acastles91/OpenCelluloid2/export.png

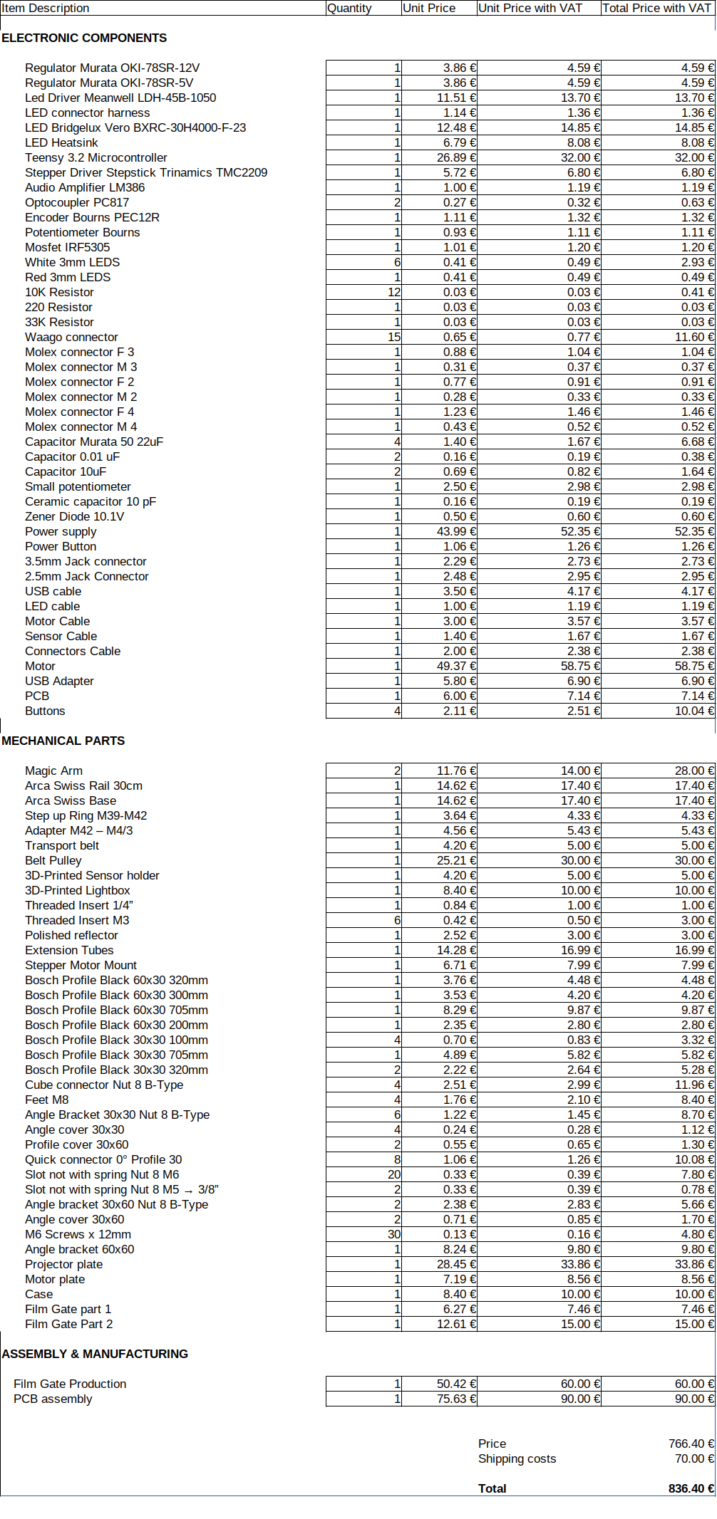
export.png
