acastles91/OpenCelluloid2/OC_Material+Einkaufs_Liste.ods

Name | Quantity | Unit Price | Total Price | Links
Regulator Murata OKI-78SR-12V | 1
Regulator Murata OKI-78SR-5V | 1
Led Driver Meanwell LDH-45B-1050 | 1
LED Bridgelux Vero | 1
Heatsink
Teensy 3.2
Stepper Driver Trinamics TMC2209
Audio Amplifier LM386
Optocoupler PC817 | 2
Encoder Bourns PEC12R
Potentiometer Bourns
Mosfet IRF5305 | 1
White 3mm LEDS | 6
Red 3mm LEDS | 1
10K Resistor | 7
30K Resistor | 1
Waago connector | 15
Molex connector 3 | 1
Molex connector 2 | 1
Molex connector 4 | 1
Magic Arm | 2 | 14,00 € | 28,00 € | https://www.ebay.de/itm/SmallRig-1498-Schwenkarm-Gelenkarm-Magic-Arm-1-4-Gewinde-drehbar-max-275mm-lang/163190397732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
Arca Swiss Schiene30cm | 1 | 17,40 € | 17,40 € | https://www.ebay.de/itm/MENGS-BPL-300-Mehrzweck-Schiene-Aluminium-Legierung-F%C3%BCr-DSLR-Kamera-Arca-Swiss/183012073690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
Arca Swiss Aufnahmeplatte | 1 | 17,40 € | 17,40 € | https://www.ebay.de/itm/MENGS-CL-90N-Schnellkupplungen-F%C3%BCr-Arca-Swiss-Platte-und-Stativ-mit-Arca-Swiss/323217049120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
Objektivadapter M42 | 1 | 4,33 € | 4,33 € | https://www.ebay.de/itm/Hohe-Pr%C3%A4zision-Metall-M39-M42-Schraube-Objektiv-Objektivadapter-Step-Up-Ri-BF/123957863239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 (https://www.ebay.de/itm/Hohe-Präzision-Metall-M39-M42-Schraube-Objektiv-Objektivadapter-Step-Up-Ri-BF/123957863239?ssPageName=STRK%3AMEBIDX%3AIT)
Objektivadapter M42 – M4/3 | 1 | 5,43 € | 5,43 € | https://www.ebay.de/itm/M42-M4-3-Adapter-f%C3%BCr-M42-Objektiv-zum-Schrauben-an-Micro-4-3-fu/283733808588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
Riemenpauschale | 1 | 5,00 € | 5,00 € | Flachrieben/ Rundriemen/ Rippenriemen
Riemenscheibe | 1 | 30,00 € | 30,00 € | eigene Fertigung
Sensor | 1 | ? | 0,00 € | ?
3D-Druck Sensorhalterung | 1 | 10,00 € | 10,00 € | eigene Fertigung
3D-Druck Lampenkammer | 1 | 20,00 € | 20,00 € | eigene Fertigung
GewindeEinsätze M3 | 5 | 5,00 € | 5,00 € | ?
Spiegelblech | 1 | 3,00 € | 3,00 € | eigene Fertigung
Extension Tubes | 1 | ? | 0,00 € | ?
Objektiv | 1 | ? | 0,00 € | ?
Schrittmotor | 1 | ? | 0,00 € | ?
Schrittmotor Aufhängung | 1 | ? | 0,00 € | ?
Boschprofil Schwarz 60x30 320mm | 1 | 4,48 € | 4,48 € | https://www.myaluprofil.de/aluminiumprofil-30x60-nut-8-b-typ-schwarz.html
Boschprofil Schwarz 60x30 300mm | 1 | 4,20 € | 4,20 € | https://www.myaluprofil.de/aluminiumprofil-30x60-nut-8-b-typ-schwarz.html
Boschprofil Schwarz 60x30 705mm | 1 | 9,87 € | 9,87 € | https://www.myaluprofil.de/aluminiumprofil-30x60-nut-8-b-typ-schwarz.html
Boschprofil Schwarz 60x30 200mm | 1 | 2,80 € | 2,80 € | https://www.myaluprofil.de/aluminiumprofil-30x60-nut-8-b-typ-schwarz.html
Boschprofil Schwarz 30x30 100mm | 4 | 0,83 € | 3,30 € | https://www.myaluprofil.de/aluminiumprofil-30x30-nut-8-b-typ-schwarz.html
Boschprofil Schwarz 30x30 705mm | 1 | 5,82 € | 5,82 € | https://www.myaluprofil.de/aluminiumprofil-30x30-nut-8-b-typ-schwarz.html
Boschprofil Schwarz 30x30 320mm | 2 | 2,64 € | 5,28 € | https://www.myaluprofil.de/aluminiumprofil-30x30-nut-8-b-typ-schwarz.html
Würfelverbindersatz Nut 8 B-Typ | 4 | 2,99 € | 11,96 € | https://www.myaluprofil.de/Wuerfelverbindersatz-30x30-Nut-8-3D-B-Typ.html
Stellfuß M8 | 4 | 2,10 € | 8,40 € | https://www.myaluprofil.de/Stellfuss-D40-M8x60-B-Typ.html
Winkelsatz 30x30 Nut 8 B-Typ | 6 | 1,45 € | 8,70 € | https://www.myaluprofil.de/Winkelsatz-30x30-ZN-Nut-8-B-Typ.html
Winkelabdeckkappe 30x30 | 4 | 0,28 € | 1,12 € | https://www.myaluprofil.de/Winkelabdeckkappe-30x30-ZN-Nut-8-B-Typ.html
Profilabdeckkappe 30x60 | 2 | 0,65 € | 1,30 € | https://www.myaluprofil.de/Profilabdeckkappe-30x60-Nut-8-B-Typ.html
Schnellspannverbinder 0° Profil 30 | 8 | 1,26 € | 10,08 € | https://www.myaluprofil.de/Schnellspannverbinder-0---Profil-30-Nut-8-B-Typ.html
Nutenstein mit Feder Nut 8 M6 | 20 | 0,39 € | 7,08 € | https://www.myaluprofil.de/Nutenstein-mit-Feder-Nut-8-M6-B-Typ.html
Nutenstein mit Feder Nut 8 M5 → 3/8” | 2 | 0,39 € | 0,78 € | https://www.myaluprofil.de/Nutenstein-mit-Feder-Nut-8-M5-B-Typ.html
Winkelsatz 30x60 Nut 8 B-Typ | 2 | 2,83 € | 5,66 € | https://www.myaluprofil.de/Winkelsatz-30x60-ZN-Nut-8-B-Typ.html
Winkelabdeckkappe 30x60 | 2 | 0,85 € | 1,70 € | https://www.myaluprofil.de/Winkelabdeckkappe-30x60-ZN-Nut-8-B-Typ.html
M6 Schrauben x 12mm | 30 | 0,16 € | 5,40 € | https://www.myaluprofil.de/halbrundschraube-iso-7380.html
Winkelsatz 60x60 | 1 | 9,80 € | 9,80 € | https://www.ebay.de/itm/Winkel-60x60-Nut-8-B-Typ-mit-Befestigungssatz-und-Abdeckkappe/274236580490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
Projektorplatte | 1 | 33,86 € | 33,86 € | GeersCutting
Motorplatte | 1 | 8,56 € | 8,56 € | GeersCutting
Caseplatte 1 | 1 | 10,00 € | 10,00 € | GeersCutting
Caseplatte 2 | 1 | 10,00 € | 10,00 € | GeersCutting
Filmgate Teil 1 | 1 | 7,46 € | 7,46 € | GeersCutting
Filmgate Teil 2 | 1 | 15,00 € | 15,00 € | GeersCutting
Filmgate Fertigungspauschale | 1 | 60,00 € | 60,00 € | eigene Fertigung
Lasern Transport Pauschale | 1 | 10,00 € | 10,00 €
 |  | Total: | 408,17 €
