acastles91/OpenCelluloid2/OpenCelluloid.kicad_pcb

## KiCad design OpenCelluloid.kicad_pcb (2021-06-12)

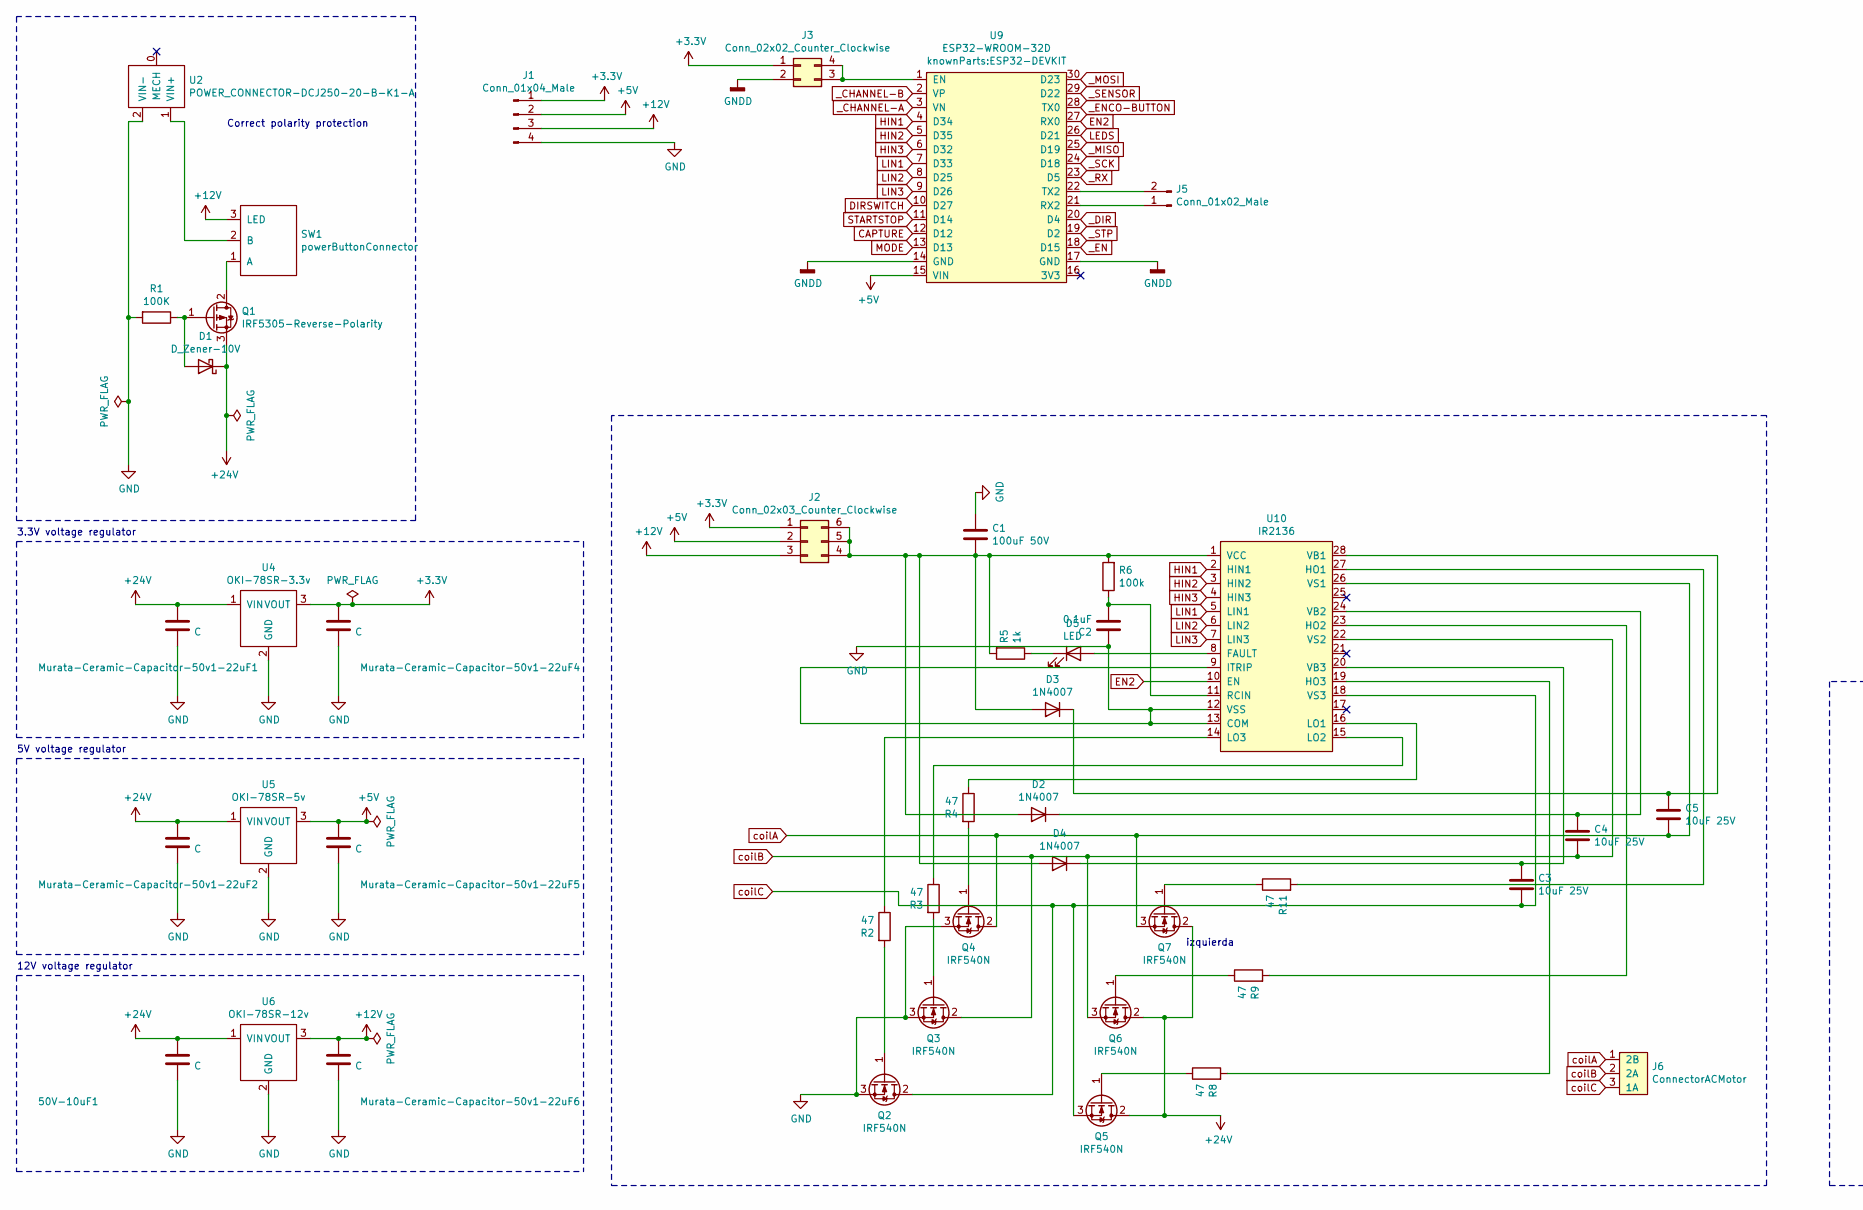
[picture p2: schematic OpenCelluloid.sch, part in row 1, column 1]

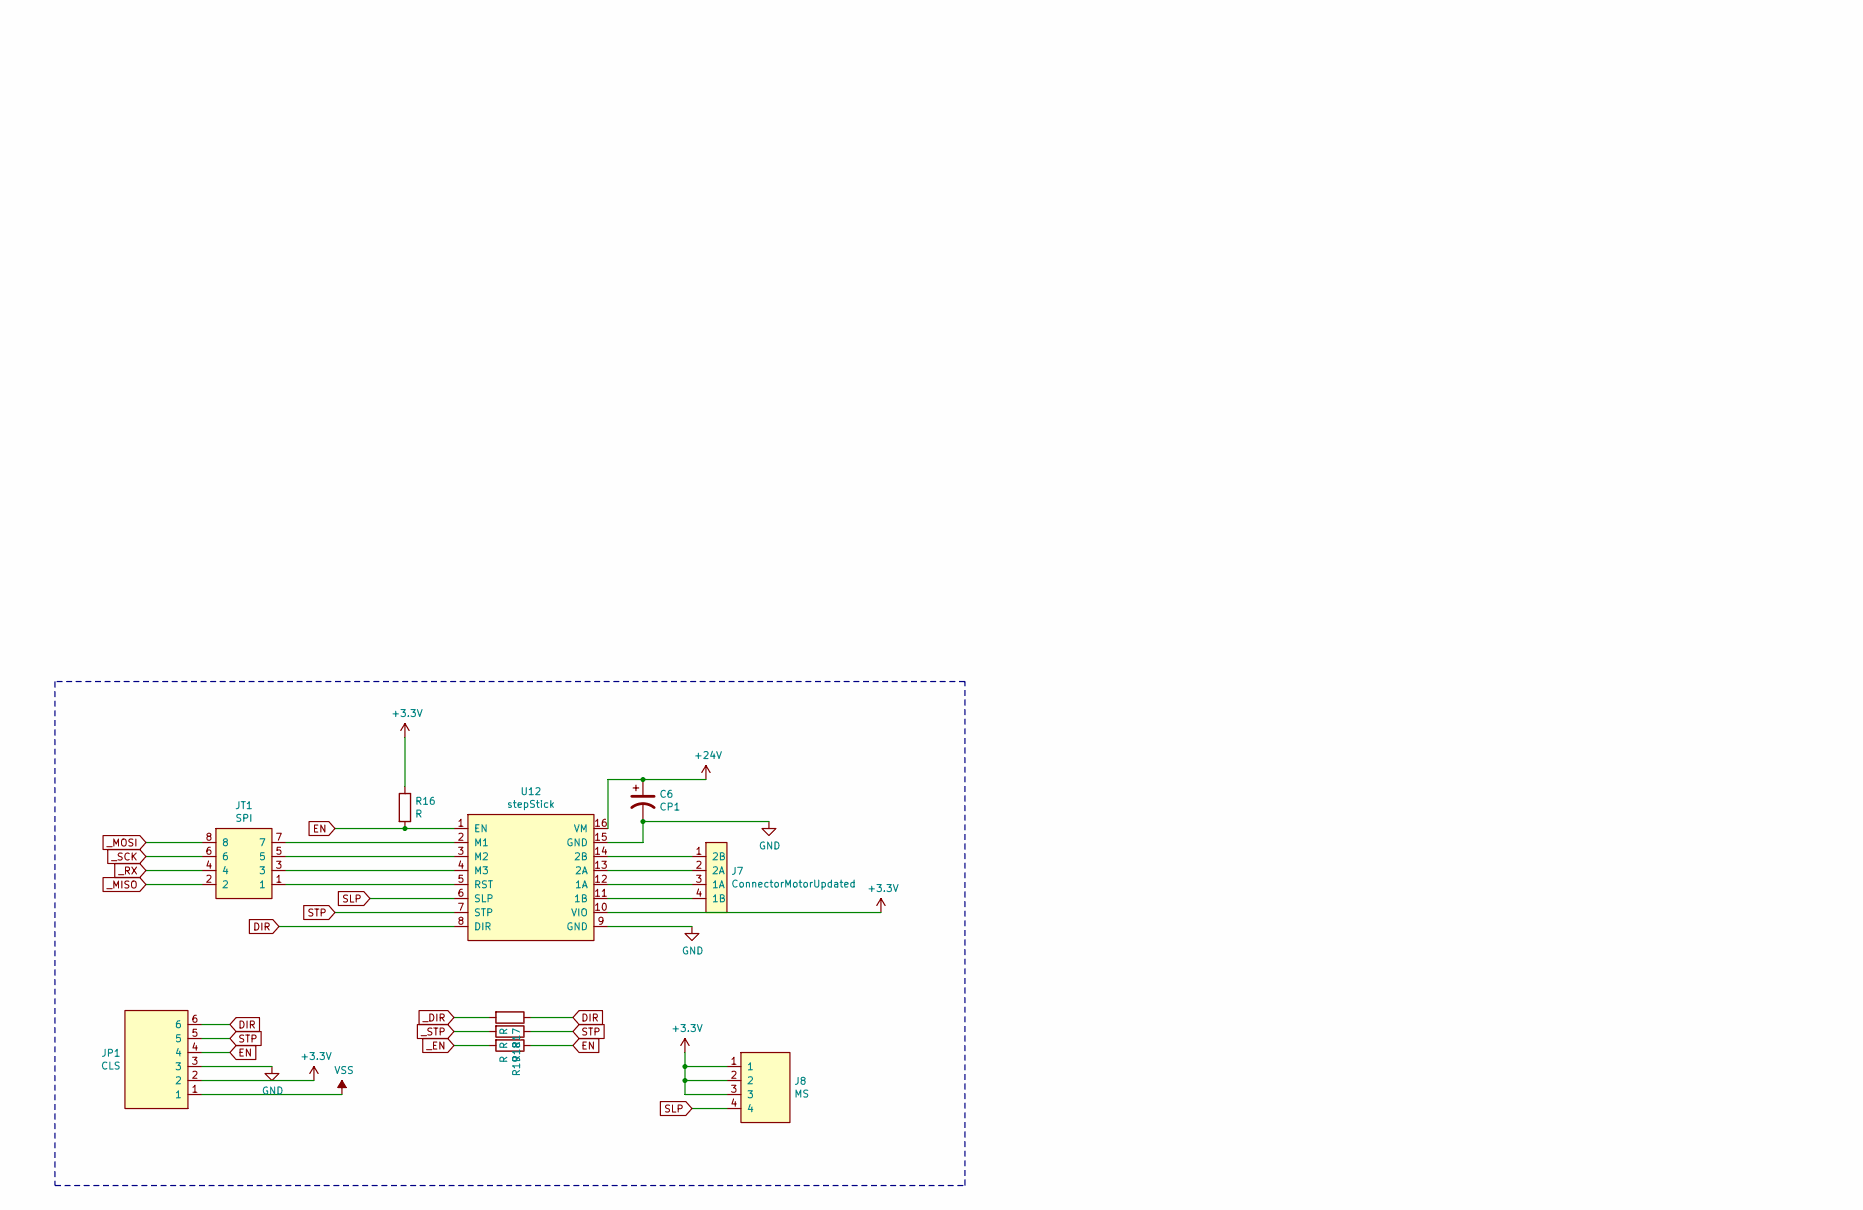
[picture p3: schematic OpenCelluloid.sch, part in row 1, column 2]

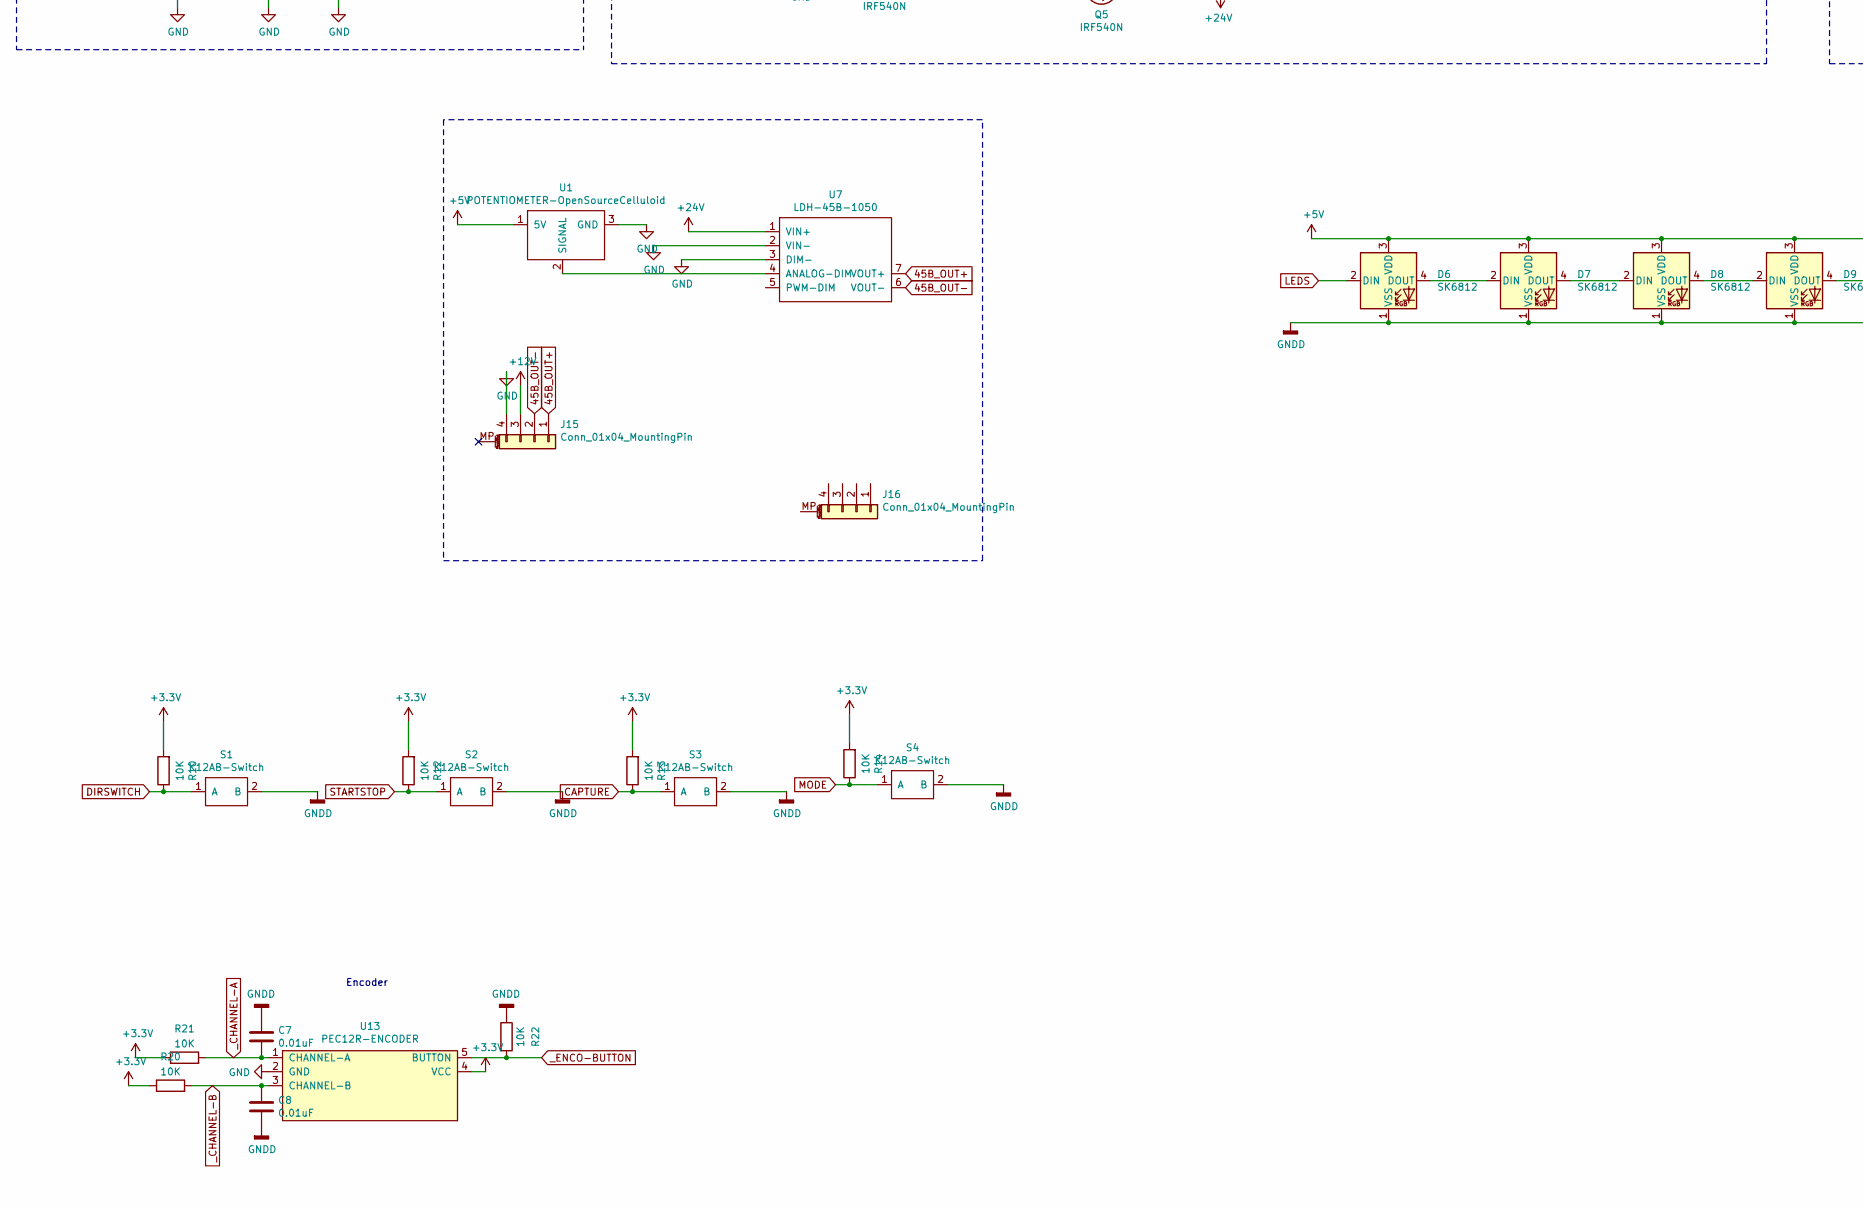
[picture p4: schematic OpenCelluloid.sch, part in row 2, column 1]

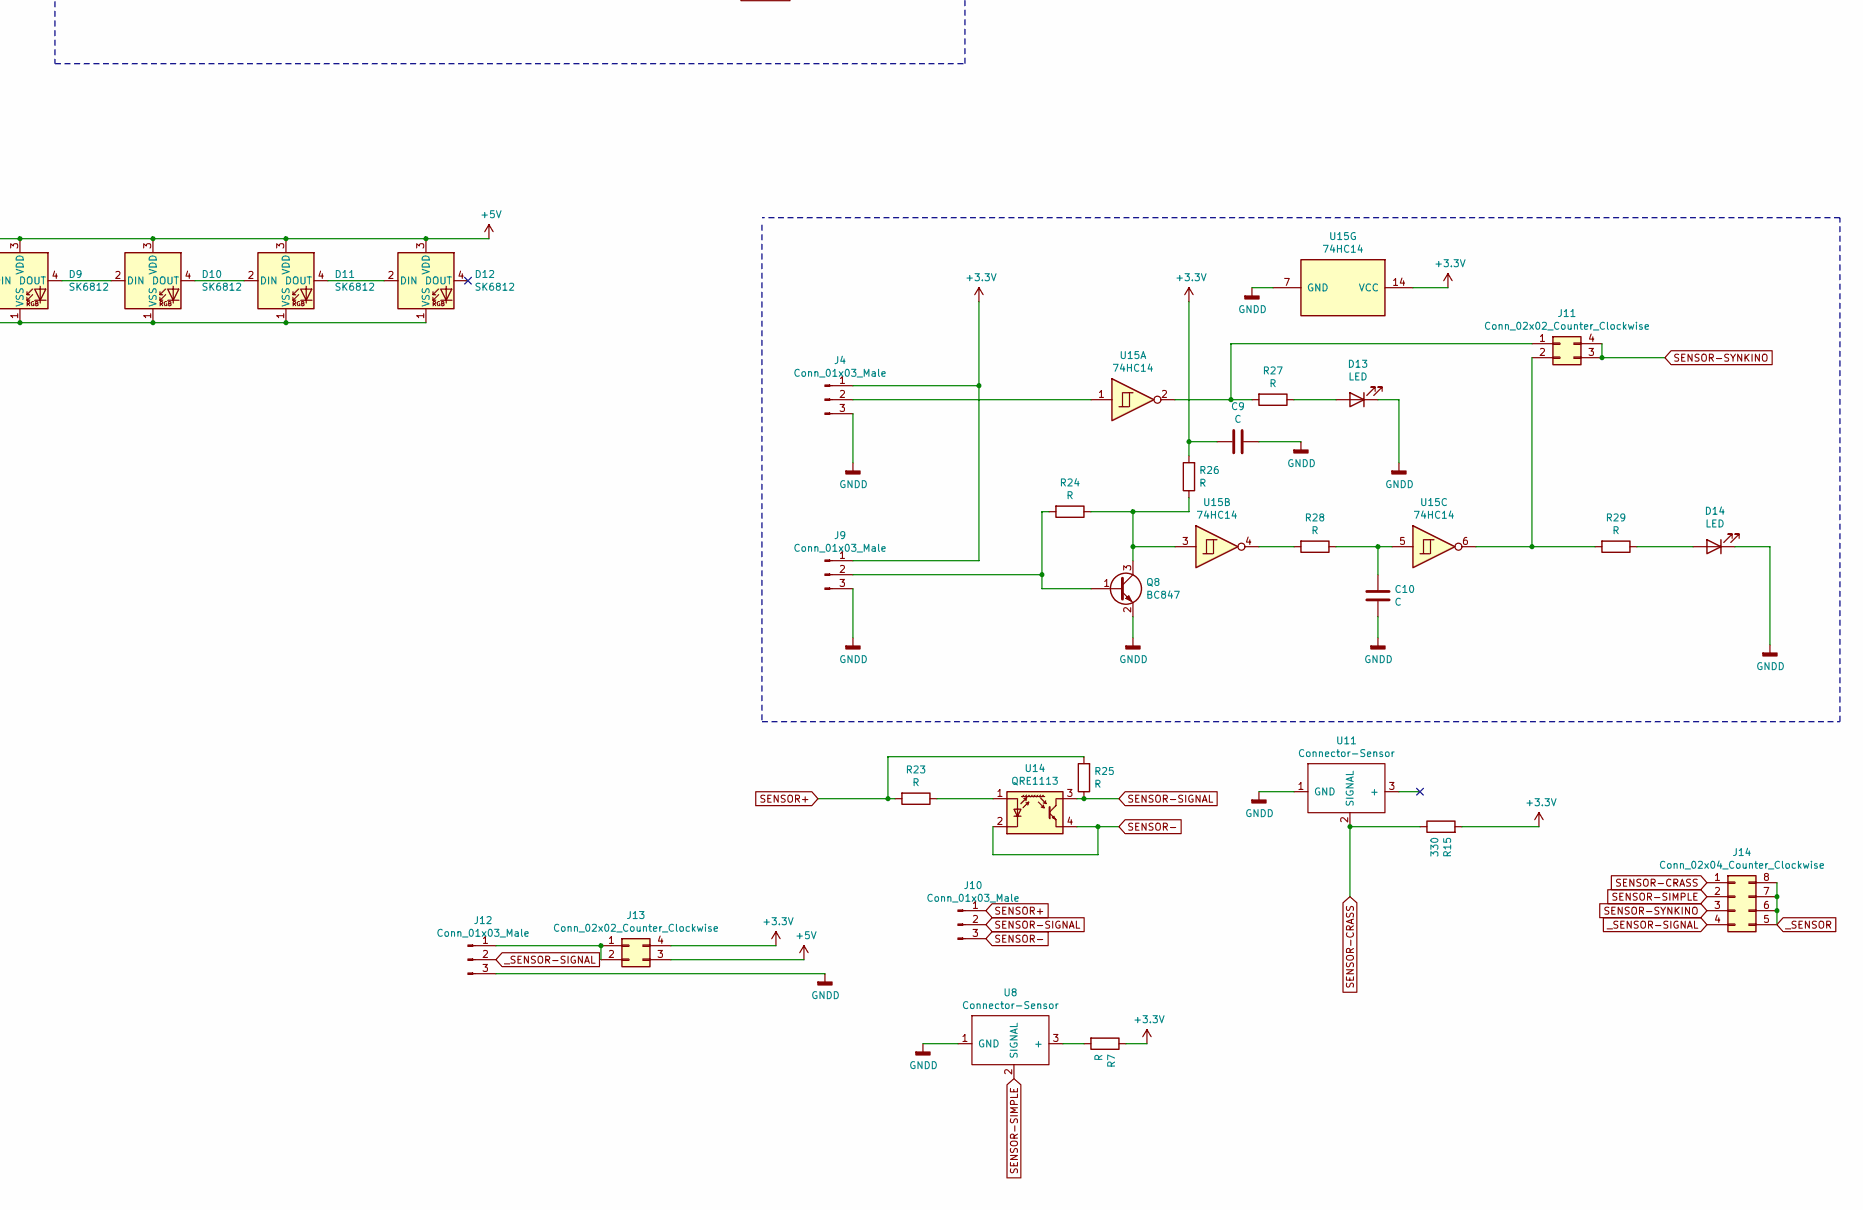
[picture p5: schematic OpenCelluloid.sch, part in row 2, column 2]

Parts:
50V-10uF1: C; C_Disc_D3.0mm_W1.6mm_P2.50mm
C1: 100uF 50V; CP_Radial_D8.0mm_P2.50mm
C2: 0.1uF; C_Disc_D3.0mm_W1.6mm_P2.50mm
C3, C4, C5: 10uF 25V; CP_Radial_D5.0mm_P2.50mm
C6: CP1; CP_Radial_D5.0mm_P2.50mm
C7, C8: 0.01uF; C_Rect_L7.0mm_W3.5mm_P5.00mm
C9, C10: C; C_Rect_L7.0mm_W3.5mm_P5.00mm
D1: D_Zener-10V; D_DO-41_SOD81_P7.62mm_Horizontal
D2, D3, D4: 1N4007; D_DO-41_SOD81_P10.16mm_Horizontal
D5, D13, D14: LED; LED_D3.0mm
D6, D7, D8, D9, D10, D11, D12: SK6812; LED_SK6812_PLCC4_5.0x5.0mm_P3.2mm
J1: Conn_01x04_Male; PinHeader_1x04_P2.54mm_Vertical
J2: Conn_02x03_Counter_Clockwise; PinHeader_2x03_P2.54mm_Vertical-CounterClockWise
J3, J11, J13: Conn_02x02_Counter_Clockwise; PinSocket_2x02_P2.54mm_Vertical_CounterClockWise
J4, J9, J10, J12: Conn_01x03_Male; JST_XH_B3B-XH-A_1x03_P2.50mm_Vertical
J5: Conn_01x02_Male; PinHeader_1x02_P2.54mm_Vertical
J6: ConnectorACMotor; Molex_Micro-Fit_3.0_43650-0300_1x03_P3.00mm_Horizontal
J7: ConnectorMotorUpdated; Molex_Micro-Fit_3.0_43650-0400_1x04_P3.00mm_Horizontal
J8: MS; PinHeader_1x04_P2.54mm_Vertical
J14: Conn_02x04_Counter_Clockwise; PinHeader_2x04_P2.54mm_Vertical-CounterClowckWise
J15: Conn_01x04_MountingPin; Molex_Micro-Fit_3.0_43650-0400_1x04_P3.00mm_Horizontal
J16: Conn_01x04_MountingPin; Vero29_w_Fan
JP1: CLS; PinHeader_1x06_P2.54mm_Vertical
JT1: SPI; PinHeader_2x04_P2.54mm_Vertical
Murata-Ceramic-Capacitor-50v1-22uF1, Murata-Ceramic-Capacitor-50v1-22uF2, Murata-Ceramic-Capacitor-50v1-22uF4, Murata-Ceramic-Capacitor-50v1-22uF5, Murata-Ceramic-Capacitor-50v1-22uF6: C; C_Disc_D3.0mm_W1.6mm_P2.50mm
Q1: IRF5305-Reverse-Polarity; TO-220-3_Horizontal_TabDown
Q2, Q3, Q4, Q5, Q6, Q7: IRF540N; TO-220-3_Horizontal_TabDown
Q8: BC847; SOT-23
R1: 100K; R_Axial_DIN0204_L3.6mm_D1.6mm_P7.62mm_Horizontal
R2, R3, R4, R8, R9, R11: 47; R_Axial_DIN0204_L3.6mm_D1.6mm_P7.62mm_Horizontal
R5: 1k; R_Axial_DIN0204_L3.6mm_D1.6mm_P7.62mm_Horizontal
R6: 100k; R_Axial_DIN0204_L3.6mm_D1.6mm_P7.62mm_Horizontal
R7, R16, R17, R18, R19, R23, R24, R25, R26, R27, R28, R29: R; R_Axial_DIN0204_L3.6mm_D1.6mm_P7.62mm_Horizontal
R10, R12, R13, R14, R20, R21, R22: 10K; R_Axial_DIN0204_L3.6mm_D1.6mm_P7.62mm_Horizontal
R15: 330; R_Axial_DIN0204_L3.6mm_D1.6mm_P7.62mm_Horizontal
S1, S2, S3, S4: K12AB-Switch
SW1: powerButtonConnector; Molex_Micro-Fit_3.0_43650-0300_1x03_P3.00mm_Horizontal
U1: POTENTIOMETER-OpenSourceCelluloid; PDB12-H4301-Potentiometer
U2: POWER_CONNECTOR-DCJ250-20-B-K1-A; POWER_JACK_DCJ250-20-B-K1-A
U4: OKI-78SR-3.3v; Converter_DCDC_muRata_OKI-78SR_Vertical
U5: OKI-78SR-5v; Converter_DCDC_muRata_OKI-78SR_Vertical
U6: OKI-78SR-12v; Converter_DCDC_muRata_OKI-78SR_Vertical
U7: LDH-45B-1050; MeanWell-LDH-45B-1050
U8, U11: Connector-Sensor; JST_XH_B3B-XH-A_1x03_P2.50mm_Vertical
U9: ESP32-WROOM-32D; ESP32-DEVKIT
U10: IR2136; DIP-28_W15.24mm_Socket_LongPads
U12: stepStick; STEPSTICK
U13: PEC12R-ENCODER; PEC12R-Encoder
U14: QRE1113; OnSemi_CASE100AQ
U15: 74HC14; DIP-14_W7.62mm_Socket

Connections:
45B_OUT+: J15.1, U7.7 (VOUT+)
45B_OUT-: J15.2, U7.6 (VOUT-)
+3V3: C9.2, J1.1, J2.1, J3.1, J4.1, J8.1, J8.2, J8.3, J9.1, J13.4, JP1.2, Murata-Ceramic-Capacitor-50v1-22uF4.1, R7.1, R10.2, R12.2, R13.2, R14.2, R15.2, R16.1, R20.1, R21.1, R26.2, U4.3 (VOUT), U12.10 (VIO), U13.4 (VCC), U15.14 (VCC)
+5V: D6.3 (VDD), D7.3 (VDD), D8.3 (VDD), D9.3 (VDD), D10.3 (VDD), D11.3 (VDD), D12.3 (VDD), J1.2, J2.2, J13.3, Murata-Ceramic-Capacitor-50v1-22uF5.1, U1.1 (5V), U5.3 (VOUT), U9.15 (VIN)
+12V: J1.3, J2.3, J15.3, Murata-Ceramic-Capacitor-50v1-22uF6.1, SW1.3 (LED), U6.3 (VOUT)
+24V: 50V-10uF1.1, C6.1, D1.1 (K), Murata-Ceramic-Capacitor-50v1-22uF1.1, Murata-Ceramic-Capacitor-50v1-22uF2.1, Q1.3 (S), Q5.2 (D), Q6.2 (D), Q7.2 (D), U4.1 (VIN), U5.1 (VIN), U6.1 (VIN), U7.1 (VIN+), U12.16 (VM)
CAPTURE: R13.1, S3.1 (A), U9.12 (D12)
DIR: JP1.6, R17.1, U12.8 (DIR)
DIRSWITCH: R10.1, S1.1 (A), U9.10 (D27)
EN: JP1.4, R16.2, R19.1, U12.1 (EN)
EN2: U9.27 (RX0), U10.10 (EN)
GND: 50V-10uF1.2, C1.1, C2.1, C6.2, J1.4, J15.4, JP1.3, Murata-Ceramic-Capacitor-50v1-22uF1.2, Murata-Ceramic-Capacitor-50v1-22uF2.2, Murata-Ceramic-Capacitor-50v1-22uF4.2, Murata-Ceramic-Capacitor-50v1-22uF5.2, Murata-Ceramic-Capacitor-50v1-22uF6.2, Q2.3 (S), Q3.3 (S), Q4.3 (S), R1.2, U1.3 (GND), U2.2 (VIN-), U4.2 (GND), U5.2 (GND), U6.2 (GND), U7.2 (VIN-), U7.3 (DIM-), U10.9 (ITRIP), U10.12 (VSS), U10.13 (COM), U12.9 (GND), U12.15 (GND), U13.2 (GND)
GNDD: C7.1, C8.2, C9.1, C10.1, D6.1 (VSS), D7.1 (VSS), D8.1 (VSS), D9.1 (VSS), D10.1 (VSS), D11.1 (VSS), D12.1 (VSS), D13.1 (K), D14.1 (K), J3.2, J4.3, J9.3, J12.3, Q8.2 (E), R22.1, S1.2 (B), S2.2 (B), S3.2 (B), S4.2 (B), U8.1 (GND), U9.14 (GND), U9.17 (GND), U11.1 (GND), U15.7 (GND)
HIN1: U9.4 (D34), U10.2 (HIN1)
HIN2: U9.5 (D35), U10.3 (HIN2)
HIN3: U9.6 (D32), U10.4 (HIN3)
LEDS: D6.2 (DIN), U9.26 (D21)
LIN1: U9.7 (D33), U10.5 (LIN1)
LIN2: U9.8 (D25), U10.6 (LIN2)
LIN3: U9.9 (D26), U10.7 (LIN3)
MODE: R14.1, S4.1 (A), U9.13 (D13)
unnamed: C1.2, D2.2 (A), D3.2 (A), D4.2 (A), J2.4, J2.5, J2.6, R5.2, R6.2, U10.1 (VCC)
unnamed: C2.2, R6.1, U10.11 (RCIN)
unnamed: C3.2, D4.1 (K), U10.20 (VB3)
unnamed: C4.2, D2.1 (K), U10.24 (VB2)
unnamed: C5.2, D3.1 (K), U10.28 (VB1)
unnamed: C10.2, R28.1, U15.5
unnamed: D1.2 (A), Q1.1 (G), R1.1
unnamed: D5.1 (K), R5.1
unnamed: D5.2 (A), U10.8 (FAULT)
unnamed: D6.4 (DOUT), D7.2 (DIN)
unnamed: D7.4 (DOUT), D8.2 (DIN)
unnamed: D8.4 (DOUT), D9.2 (DIN)
unnamed: D9.4 (DOUT), D10.2 (DIN)
unnamed: D10.4 (DOUT), D11.2 (DIN)
unnamed: D11.4 (DOUT), D12.2 (DIN)
unnamed: D13.2 (A), R27.1
unnamed: D14.2 (A), R29.1
unnamed: J3.3, J3.4, U9.1 (EN)
unnamed: J4.2, U15.1
unnamed: J5.1, U9.21 (RX2)
unnamed: J5.2, U9.22 (TX2)
unnamed: J7.1 (2B), U12.14 (2B)
unnamed: J7.2 (2A), U12.13 (2A)
unnamed: J7.3 (1A), U12.12 (1A)
unnamed: J7.4 (1B), U12.11 (1B)
unnamed: J9.2, Q8.1 (B), R24.2
unnamed: J11.1, R27.2, U15.2
unnamed: J11.2, R29.2, U15.6
unnamed: J12.1, J13.1, J13.2
unnamed: JT1.1, U12.5 (RST)
unnamed: JT1.3, U12.4 (M3)
unnamed: JT1.5, U12.3 (M2)
unnamed: JT1.7, U12.2 (M1)
unnamed: Q1.2 (D), SW1.1 (A)
unnamed: Q2.1 (G), R2.2
unnamed: Q3.1 (G), R3.2
unnamed: Q4.1 (G), R4.2
unnamed: Q5.1 (G), R8.1
unnamed: Q6.1 (G), R9.1
unnamed: Q7.1 (G), R11.1
unnamed: Q8.3 (C), R24.1, R26.1, U15.3
unnamed: R2.1, U10.14 (LO3)
unnamed: R3.1, U10.15 (LO2)
unnamed: R4.1, U10.16 (LO1)
unnamed: R7.2, U8.3 (+)
unnamed: R8.2, U10.19 (HO3)
unnamed: R9.2, U10.23 (HO2)
unnamed: R11.2, U10.27 (HO1)
unnamed: R23.1, U14.1 (A)
unnamed: R28.2, U15.4
unnamed: SW1.2 (B), U2.1 (VIN+)
unnamed: U1.2 (SIGNAL), U7.4 (ANALOG-DIM)
SENSOR+: J10.1, R23.2, R25.2
SENSOR-: J10.3, U14.2 (K), U14.4
SENSOR-CRASS: J14.1, R15.1, U11.2 (SIGNAL)
SENSOR-SIGNAL: J10.2, R25.1, U14.3
SENSOR-SIMPLE: J14.2, U8.2 (SIGNAL)
SENSOR-SYNKINO: J11.3, J11.4, J14.3
SLP: J8.4, U12.6 (SLP)
STARTSTOP: R12.1, S2.1 (A), U9.11 (D14)
STP: JP1.5, R18.1, U12.7 (STP)
VSS: JP1.1
_CHANNEL-A: C7.2, R21.2, U9.3 (VN), U13.1 (CHANNEL-A)
_CHANNEL-B: C8.1, R20.2, U9.2 (VP), U13.3 (CHANNEL-B)
_DIR: R17.2, U9.20 (D4)
_EN: R19.2, U9.18 (D15)
_ENCO-BUTTON: R22.2, U9.28 (TX0), U13.5 (BUTTON)
_MISO: JT1.2, U9.25 (D19)
_MOSI: JT1.8, U9.30 (D23)
_RX: JT1.4, U9.23 (D5)
_SCK: JT1.6, U9.24 (D18)
_SENSOR: J14.5, J14.6, J14.7, J14.8, U9.29 (D22)
_SENSOR-SIGNAL: J12.2, J14.4
_STP: R18.2, U9.19 (D2)
coilA: C5.1, J6.1 (2B), Q4.2 (D), Q7.3 (S), U10.26 (VS1)
coilB: C4.1, J6.2 (2A), Q3.2 (D), Q6.3 (S), U10.22 (VS2)
coilC: C3.1, J6.3 (1A), Q2.2 (D), Q5.3 (S), U10.18 (VS3)

Notes on the sheet:
Correct polarity protection
5V voltage regulator
3.3V voltage regulator
12V voltage regulator
izquierda
Encoder

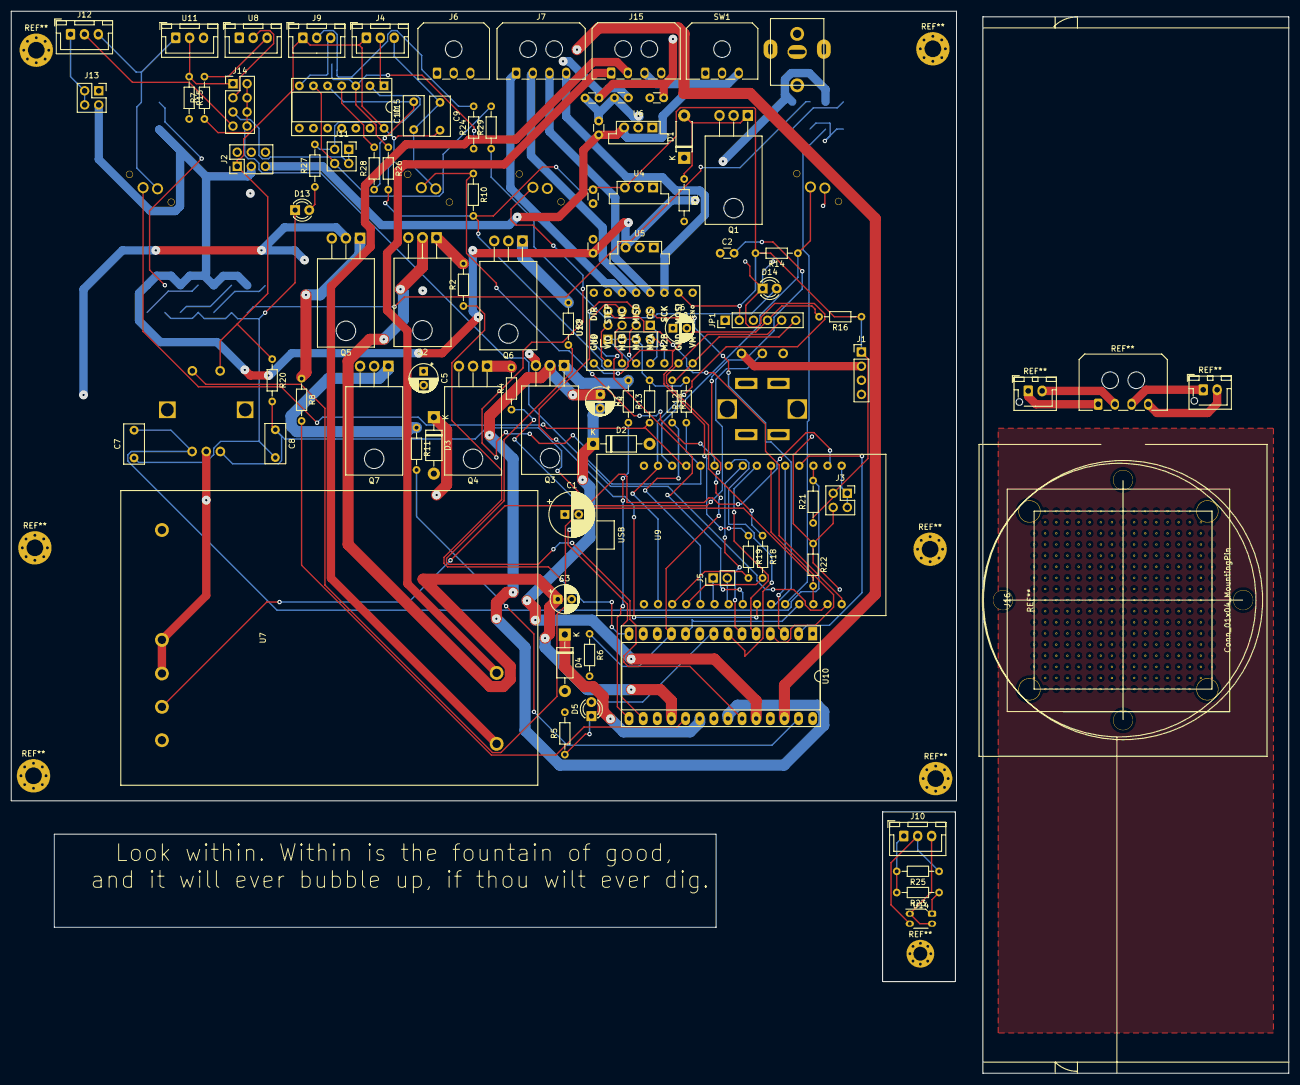
[picture p6: board OpenCelluloid.kicad_pcb from above]

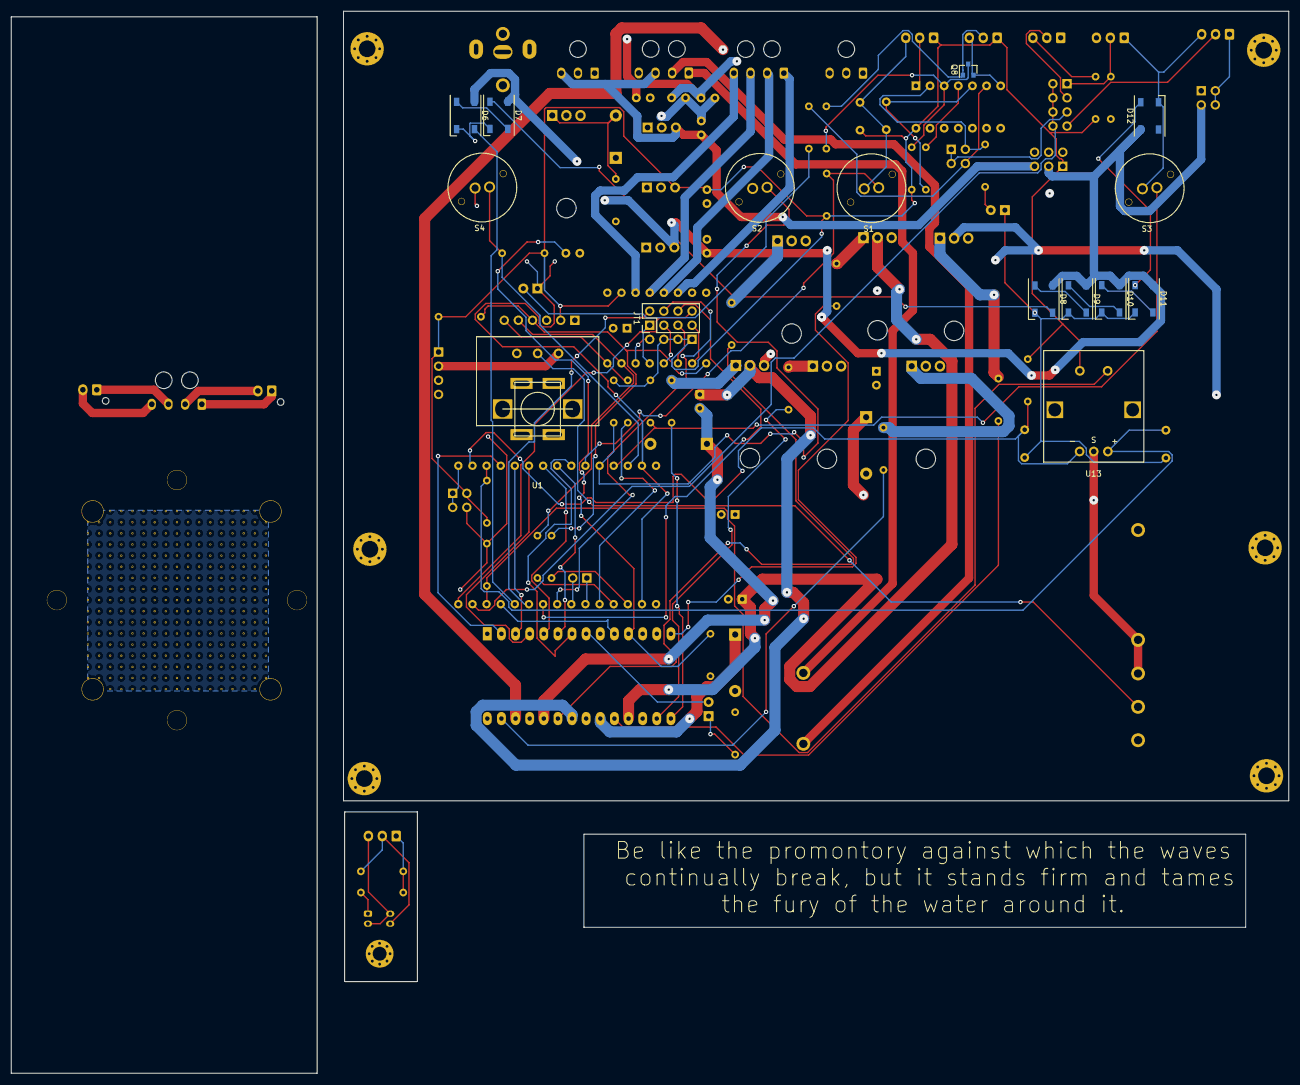
[picture p7: board OpenCelluloid.kicad_pcb from below]

Board: 4 copper layers, 229.8 x 191.0 mm, 104 parts (15 on the bottom side), 97 nets.
