acastles91/OpenCelluloid2/(commit log)

2021-06-12 After pcb production
    [Bom_8633157.csv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]
2021-06-25 tabla precios
    [OC_Material+Einkaufs_Liste.ods]
